gsapijaszko/mySensors_pir_relay/README.md

# mySensors_pir_relay
PIR/light relay with nRF24 radio, mySensors network

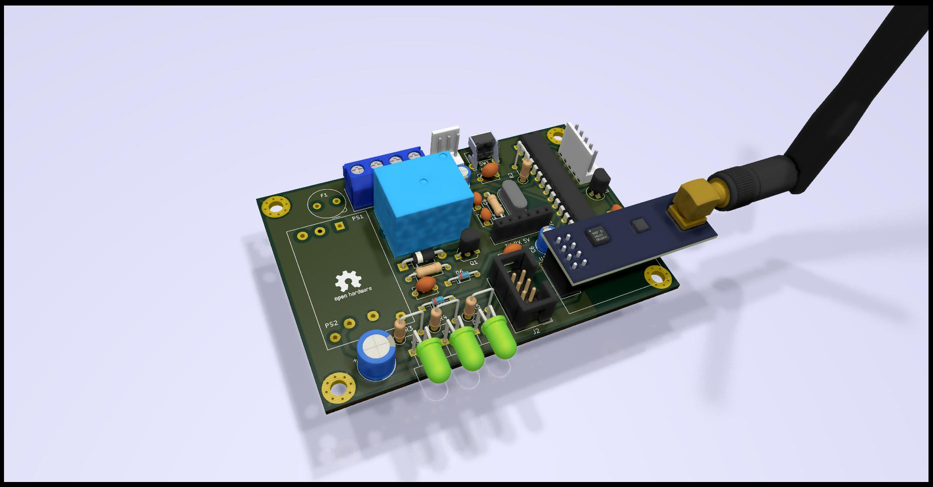
[picture p1: hardware/atmega328.jpg]
