gsapijaszko/mySensors_pir_relay/hardware/atmega328.ods

Source: | C:\projekty\atmega\atmega328\atmega328.sch
Date: | 2018-12-29 16:24:20
Tool: | Eeschema (6.0.0-rc1-dev-1429-g0c0dda54b)
Generator: | C:\Program Files (x86)\KiCad\bin\scripting\plugins/bom_csv_grouped_by_value_with_fp.py
Component Count: | 34
Ref | Qnty | Value | Cmp name | Footprint | Description | Vendor | Price | Currency | Value
C2, | 1 | 220uF | CP | Capacitor_THT:CP_Radial_D10.0mm_P5.00mm | Polarized capacitor |  | 0,1172 | PLN | 0,1172
C3, C1, | 2 | 22p | C | Capacitor_THT:C_Disc_D3.8mm_W2.6mm_P2.50mm | Unpolarized capacitor |  | 0,0517 | PLN | 0,1034
C7, C4, C6, | 3 | 100n | C | Capacitor_THT:C_Disc_D7.5mm_W5.0mm_P7.50mm | Unpolarized capacitor |  | 0,0517 | PLN | 0,1551
C8, C5, | 2 | 47uF | CP | Capacitor_THT:CP_Radial_D6.3mm_P2.50mm | Polarized capacitor |  | 0,1172 | PLN | 0,2344
D1, | 1 | 1N4145 | D | Diode_THT:D_DO-34_SOD68_P7.62mm_Horizontal | Diode |  |  |  | 0
D2, | 1 | 1N4007 | D | Diode_THT:D_DO-41_SOD81_P10.16mm_Horizontal | Diode |  |  |  | 0
D3, | 1 | 1N4148 | D | Diode_THT:D_DO-34_SOD68_P7.62mm_Horizontal | Diode |  |  |  | 0
D4, | 1 | red | LED | LED_THT:LED_D5.0mm_Horizontal_O3.81mm_Z9.0mm | Light emitting diode |  | 0,0363 | PLN | 0,0363
D5, | 1 | green | LED | LED_THT:LED_D5.0mm_Horizontal_O3.81mm_Z9.0mm | Light emitting diode |  | 0,0363 | PLN | 0,0363
D6, | 1 | yellow | LED | LED_THT:LED_D5.0mm_Horizontal_O3.81mm_Z9.0mm | Light emitting diode |  | 0,0363 | PLN | 0,0363
F1, | 1 | 500mA | Fuse | Fuse:Fuseholder_TR5_Littelfuse_No560_No460 | Fuse |  | 0,222 | PLN | 0,222
J1, | 1 | 220V | Conn_01x02_Male | kicad_libraries:KF301-2P-5.0 | Generic connector, single row, 01x02, script generated (kicad-library-utils/schlib/autogen/connector/) |  | 0,182 | PLN | 0,182
J2, | 1 | AVR-ISP-6 | AVR-ISP-6 | Connector_IDC:IDC-Header_2x03_P2.54mm_Vertical | Atmel 6-pin ISP connector |  |  |  | 0
J3, | 1 | PIR | Conn_01x03_Male | IFS_Connectors:KF2510-A-3P-M-TH-V | Generic connector, single row, 01x03, script generated (kicad-library-utils/schlib/autogen/connector/) |  | 2,908 | PLN | 2,908
J4, | 1 | BH1750 | Conn_01x05_Male | kicad_libraries:KF2510-A-5P-M-TH-V | Generic connector, single row, 01x05, script generated (kicad-library-utils/schlib/autogen/connector/) |  | 3,21 | PLN | 3,21
J5, | 1 | LAMP | Conn_01x02_Male | kicad_libraries:KF301-2P-5.0 | Generic connector, single row, 01x02, script generated (kicad-library-utils/schlib/autogen/connector/) |  | 0,182 | PLN | 0,182
K1, | 1 | SANYOU_SRD_Form_C | SANYOU_SRD_Form_C | Relay_THT:Relay_SPDT_SANYOU_SRD_Series_Form_C | Sanyo SRD relay, Single Pole Miniature Power Relay, |  | 1,2692 |  | 1,2692
PS1, | 1 | AC_DC_5V_3W | AC_DC_5V_3W-Converter_ACDC | Converter_ACDC:AC_DC_5V_3W |  |  | 2,87 |  | 2,87
Q1, | 1 | BC547 | BC547 | Package_TO_SOT_THT:TO-92_Inline | 0.1A Ic, 45V Vce, Small Signal NPN Transistor, TO-92 |  | 0,047666666666667 |  | 0,047666666666667
R1, | 1 | 1M | R | Resistor_THT:R_Axial_DIN0207_L6.3mm_D2.5mm_P10.16mm_Horizontal | Resistor |  | 0,01 |  | 0,01
R2, | 1 | 10k | R | Resistor_THT:R_Axial_DIN0207_L6.3mm_D2.5mm_P5.08mm_Vertical | Resistor |  | 0,01 |  | 0,01
R3, | 1 | 10k | R | Resistor_THT:R_Axial_DIN0207_L6.3mm_D2.5mm_P10.16mm_Horizontal | Resistor |  | 0,01 |  | 0,01
R4, R5, R6, | 3 | 470 | R | Resistor_THT:R_Axial_DIN0207_L6.3mm_D2.5mm_P5.08mm_Vertical | Resistor |  | 0,01 |  | 0,03
SW1, | 1 | SW_Push | SW_Push | Button_Switch_THT:SW_Tactile_SKHH_Angled | Push button switch, generic, two pins |  |  |  | 0
U1, | 1 | NRF24L01_Breakout | NRF24L01_Breakout | RF_Module:nRF24L01_Breakout | Ultra low power 2.4GHz RF Transceiver, Carrier PCB |  | 6,74 | PLN | 6,74
U2, | 1 | L78L33_TO92 | L78L33_TO92 | Package_TO_SOT_THT:TO-92_Inline | Positive 100mA 30V Linear Regulator, Fixed Output 3.3V, TO-92 |  | 0,398 | PLN | 0,398
U3, | 1 | ATmega328-PU | ATmega328-PU | Package_DIP:DIP-28_W7.62mm | 20MHz, 32kB Flash, 2kB SRAM, 1kB EEPROM, DIP-28 |  | 5 |  | 5
Y1, | 1 | Crystal | Crystal | Crystal:Crystal_HC49-U_Vertical | Two pin crystal |  | 0,2055 |  | 0,2055
 |  |  |  |  |  |  |  |  | 24,0133666666667
