gsapijaszko/mySensors_pir_relay/case/assembly.fcstd

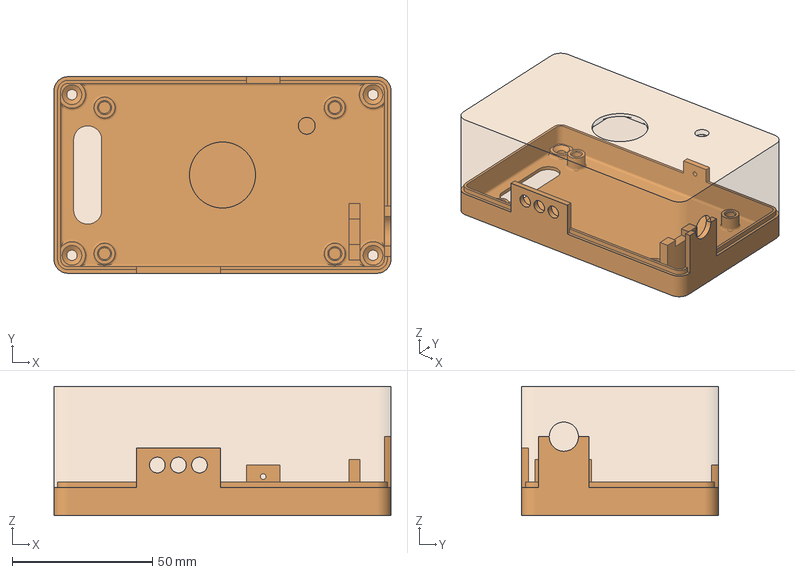
[picture p2: CAD file, 2020-01-12]
case/assembly.fcstd
120.0 x 70.0 x 46.0 mm
BottomPart
TopPart
