gsapijaszko/mySensors_pir_relay/hardware/atmega328.FCStd

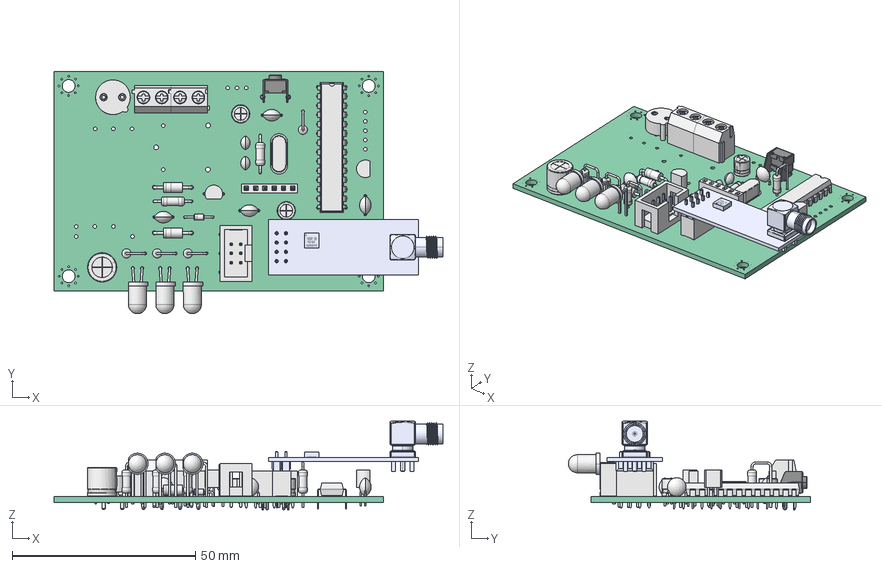
[picture p3: CAD file, 2020-01-12]
hardware/atmega328.FCStd
106.3 x 66.2 x 24.2 mm
Pcb_f059
C8_CP_Radial_D50mm_P200mm_5C228BFC x 2
D1_D_DO-41_SOD81_P10.16mm_Horizontal_5C228C1B x 2
C5_C_Disc_D51mm_W32mm_P500mm_5C2C32D8 x 4
J5_PinSocket_1x06_P254mm_Vertical_5C2BABEE
Y1_Crystal_HC49-4H_Vertical_5C2673D7
C1_CP_Radial_D80mm_P350mm_5C22DB62
U2_TO-92_Narrow_5C27EEBB
Q1_TO-92_Inline_Wide_5C2949E0
J6_TE_1776244-008_sp_5C2859B0 x 2
SW1_tactileswitch-right-angle-5mm_5C27D3F6[2]
J2_IDC_Header_2x03_P254mm_Vertical_5C228C8A
R5_R_Axial_DIN0207_L63mm_D25mm_P508mm_Vertical_5C26CE50 x 4
D5_LED_D5.0mm_Horizontal_O3.81mm_Z9.0mm_5C26CC1D x 3
F1_A_Littelfuse_No560_No460_5C258DC7
D6_D_DO-34_SOD68_P7.62mm_Horizontal_5C228C59
C4_C_Disc_D38mm_W26mm_P250mm_5C228A95 x 2
R1_R_Axial_DIN0207_L63mm_D25mm_P1016mm_Horizontal_5C228D38 x 2
U3_DIP-28_W7.62mm_5C27EC37
U1_NRF24L01_PCB_sp_5C228DAA[2]
U1_PinSocket_2x04_P254mm_Vertical_5C228DAA[3]
