gsapijaszko/mySensors_pir_relay/case/TopPart.stl

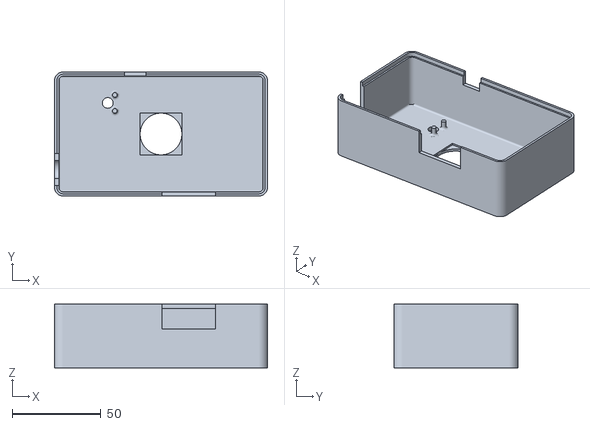
[picture p4: CAD file, 2020-01-12]
case/TopPart.stl
120.0 x 70.0 x 36.0
