gsapijaszko/mySensors_pir_relay/case/PIR_sensor.FCStd

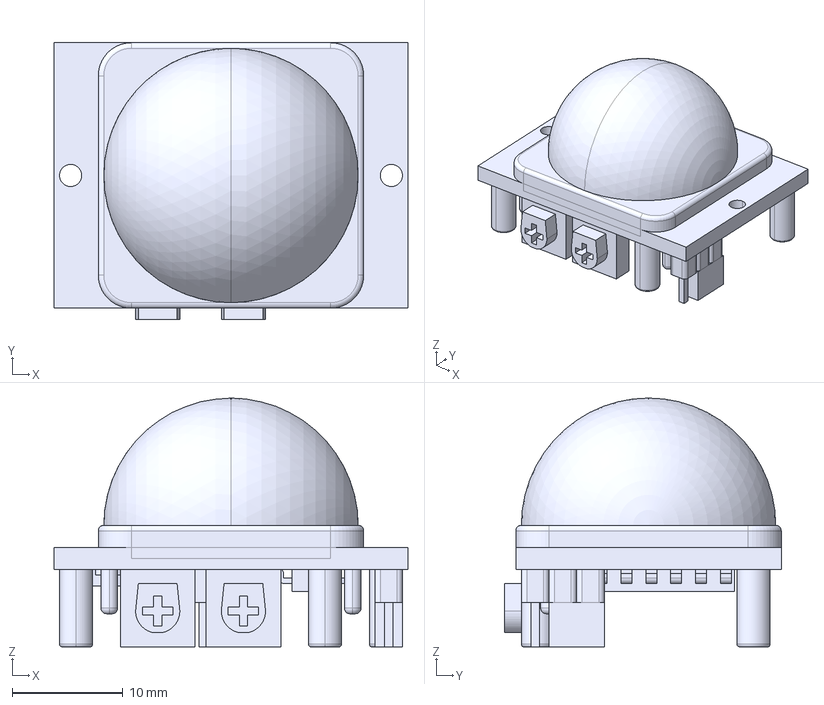
[picture p5: CAD file, 2019-01-06]
case/PIR_sensor.FCStd
32.0 x 25.0 x 22.5 mm
