gsapijaszko/mySensors_pir_relay/(list of files, cad)

Other CAD files:
hardware/atmega3281.FCStd
