gsapijaszko/mySensors_pir_relay/(list of files, drawings)

Other design files:
hardware/atmega328.dsn
