gsapijaszko/mySensors_pir_relay/hardware/atmega328.kicad_pcb

## KiCad design hardware/atmega328.kicad_pcb (2019-02-11)

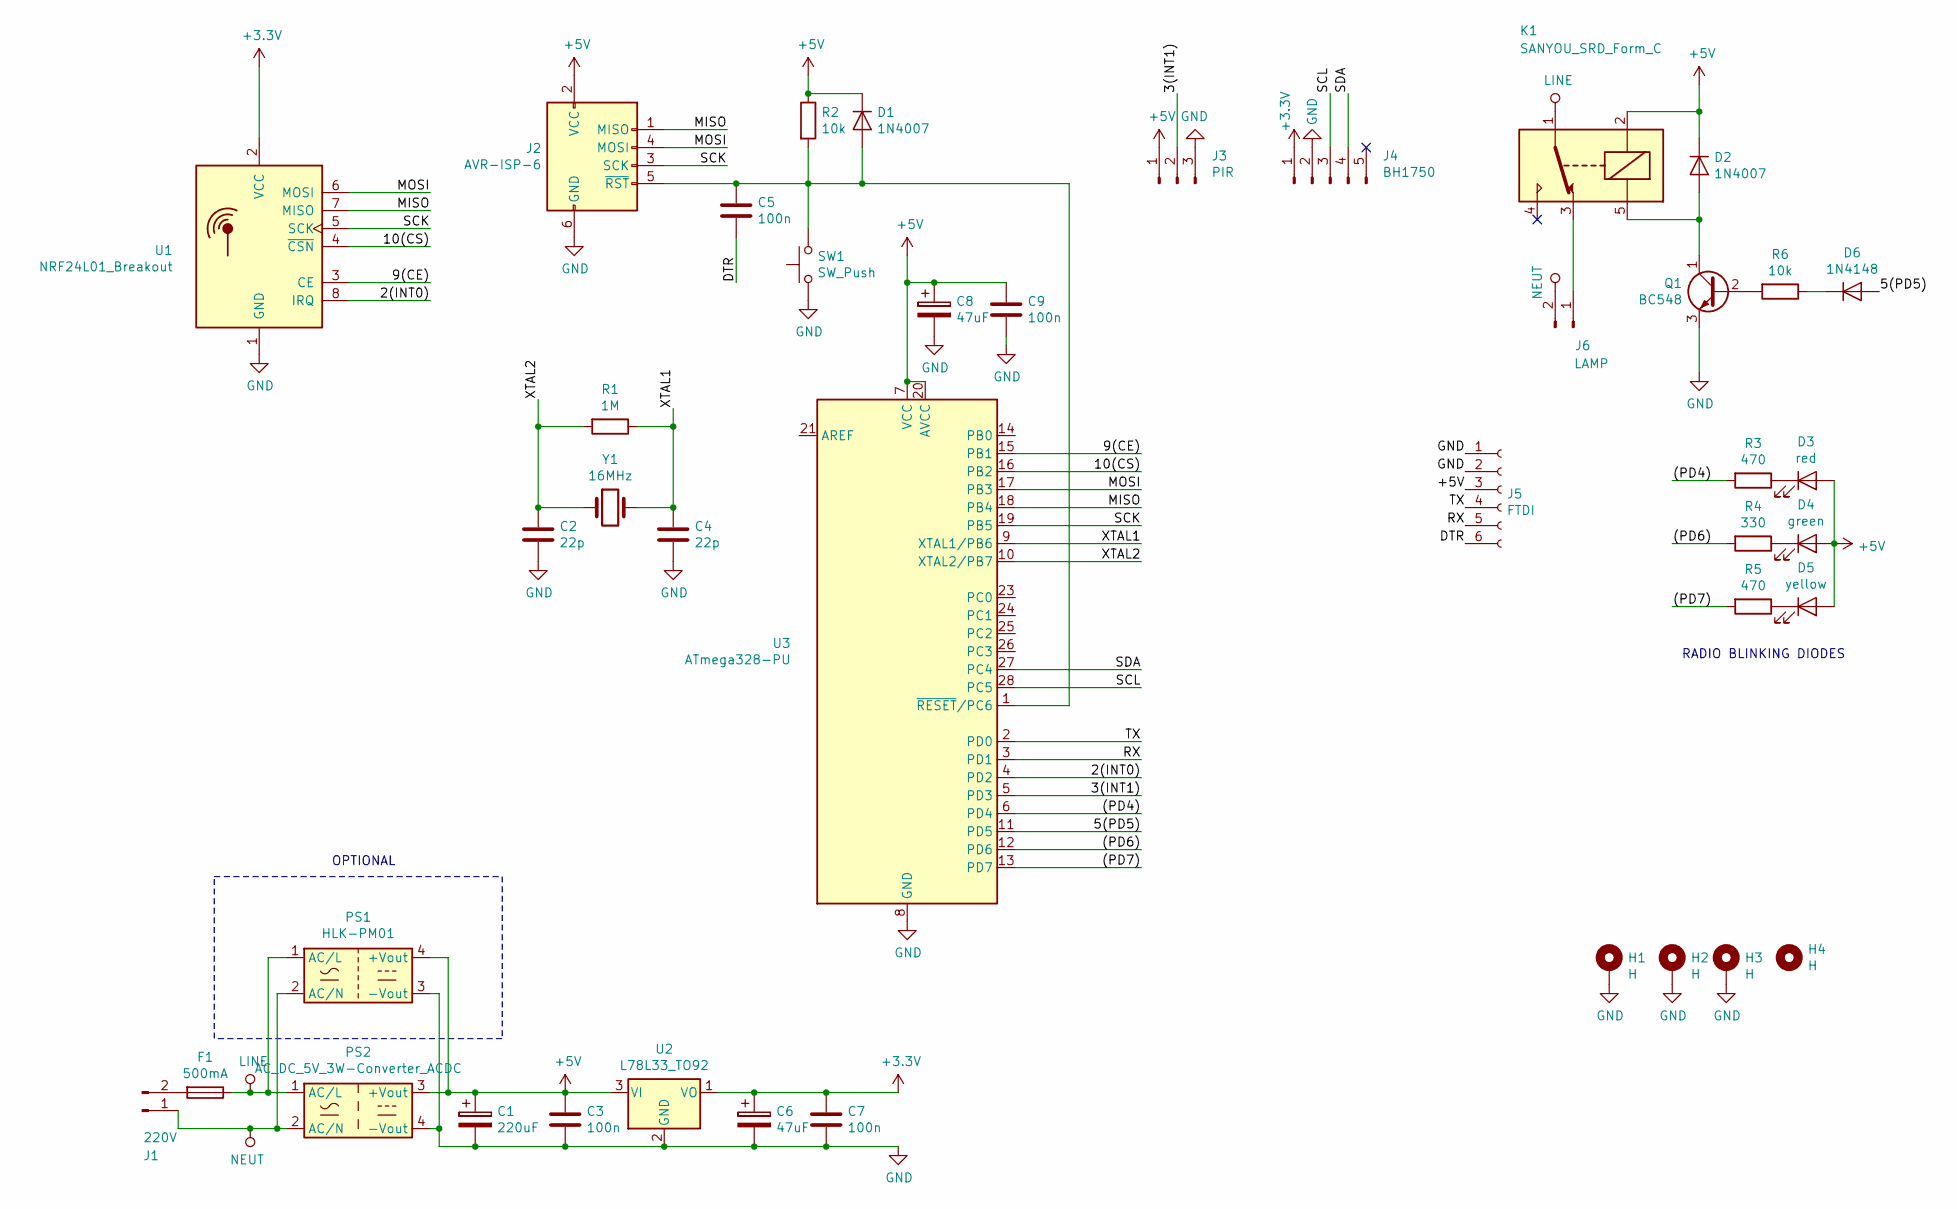
[picture p6: schematic atmega328.sch, mySensors PIR/BH1750 relay]

Parts:
C1: 220uF; CP_Radial_D8.0mm_P3.50mm
C2, C4: 22p; C_Disc_D3.8mm_W2.6mm_P2.50mm
C3, C5, C7, C9: 100n; C_Disc_D5.1mm_W3.2mm_P5.00mm
C6, C8: 47uF; CP_Radial_D5.0mm_P2.00mm
D1, D2: 1N4007; D_DO-41_SOD81_P10.16mm_Horizontal
D3: red; LED_D5.0mm_Horizontal_O3.81mm_Z9.0mm
D4: green; LED_D5.0mm_Horizontal_O3.81mm_Z9.0mm
D5: yellow; LED_D5.0mm_Horizontal_O3.81mm_Z9.0mm
D6: 1N4148; D_DO-34_SOD68_P7.62mm_Horizontal
F1: 500mA; Fuseholder_TR5_Littelfuse_No560_No460
H1, H2, H3, H4: H; MountingHole_3.5mm_Pad_Via
J1: 220V; KF301-2P-5.0
J2: AVR-ISP-6; IDC-Header_2x03_P2.54mm_Vertical
J3: PIR; KF2510-A-3P-M-TH-V
J4: BH1750; KF2510-A-5P-M-TH-V
J5: FTDI; PinSocket_1x06_P2.54mm_Vertical
J6: LAMP; KF301-2P-5.0
K1: SANYOU_SRD_Form_C; Relay_SPDT_SANYOU_SRD_Series_Form_C
PS1: HLK-PM01; Converter_ACDC_HiLink_HLK-PMxx
PS2: AC_DC_5V_3W-Converter_ACDC; AC_DC_5V_3W
Q1: BC548; TO-92_Inline_Wide
R1: 1M; R_Axial_DIN0207_L6.3mm_D2.5mm_P10.16mm_Horizontal
R2: 10k; R_Axial_DIN0207_L6.3mm_D2.5mm_P5.08mm_Vertical
R3, R5: 470; R_Axial_DIN0207_L6.3mm_D2.5mm_P5.08mm_Vertical
R4: 330; R_Axial_DIN0207_L6.3mm_D2.5mm_P5.08mm_Vertical
R6: 10k; R_Axial_DIN0207_L6.3mm_D2.5mm_P10.16mm_Horizontal
SW1: SW_Push; SW_Tactile_SKHH_Angled
U1: NRF24L01_Breakout; nRF24L01_Breakout
U2: L78L33_TO92; TO-92
U3: ATmega328-PU; DIP-28_W7.62mm
Y1: 16MHz; Crystal_HC49-4H_Vertical

Connections:
+3V3: C6.1, C7.1, J4.1, U1.2 (VCC), U2.1 (VO)
+5V: C1.1, C3.1, C8.1, C9.1, D1.1 (K), D2.1 (K), D3.2 (A), D4.2 (A), D5.2 (A), J2.2 (VCC), J3.1, J5.3, K1.2, PS1.4 (+Vout), PS2.3 (+Vout), R2.1, U2.3 (VI), U3.7 (VCC), U3.20 (AVCC)
/2(INT0): U1.8 (IRQ), U3.4 (PD2)
/3(INT1): J3.2, U3.5 (PD3)
/5(PD5): D6.2 (A), U3.11 (PD5)
/9(CE): U1.3 (CE), U3.15 (PB1)
/10(CS): U1.4 (~CSN), U3.16 (PB2)
/(PD4): R3.2, U3.6 (PD4)
/(PD6): R4.2, U3.12 (PD6)
/(PD7): R5.2, U3.13 (PD7)
/DTR: C5.2, J5.6
/MISO: J2.1 (MISO), U1.7 (MISO), U3.18 (PB4)
/MOSI: J2.4 (MOSI), U1.6 (MOSI), U3.17 (PB3)
/RX: J5.5, U3.3 (PD1)
/SCK: J2.3 (SCK), U1.5 (SCK), U3.19 (PB5)
/SCL: J4.3, U3.28 (PC5)
/SDA: J4.4, U3.27 (PC4)
/TX: J5.4, U3.2 (PD0)
/XTAL1: C4.1, R1.1, U3.9 (XTAL1/PB6), Y1.2
/XTAL2: C2.1, R1.2, U3.10 (XTAL2/PB7), Y1.1
GND: C1.2, C2.2, C3.2, C4.2, C6.2, C7.2, C8.2, C9.2, H1.1, H2.1, H3.1, J2.6 (GND), J3.3, J4.2, J5.1, J5.2, PS1.3 (-Vout), PS2.4 (-Vout), Q1.3 (E), SW1.1, U1.1 (GND), U2.2 (GND), U3.8 (GND), U3.22 (GND)
LINE: F1.1, K1.1, PS1.1 (AC/L), PS2.1 (AC/L)
NEUT: J1.1, J6.2, PS1.2 (AC/N), PS2.2 (AC/N)
unnamed: C5.1, D1.2 (A), J2.5 (~RST), R2.2, SW1.2, U3.1 (~RESET~/PC6)
unnamed: D2.2 (A), K1.5, Q1.1 (C)
unnamed: D3.1 (K), R3.1
unnamed: D4.1 (K), R4.1
unnamed: D5.1 (K), R5.1
unnamed: D6.1 (K), R6.1
unnamed: F1.2, J1.2
unnamed: J6.1, K1.3
unnamed: Q1.2 (B), R6.2

Notes on the sheet:
RADIO BLINKING DIODES
OPTIONAL

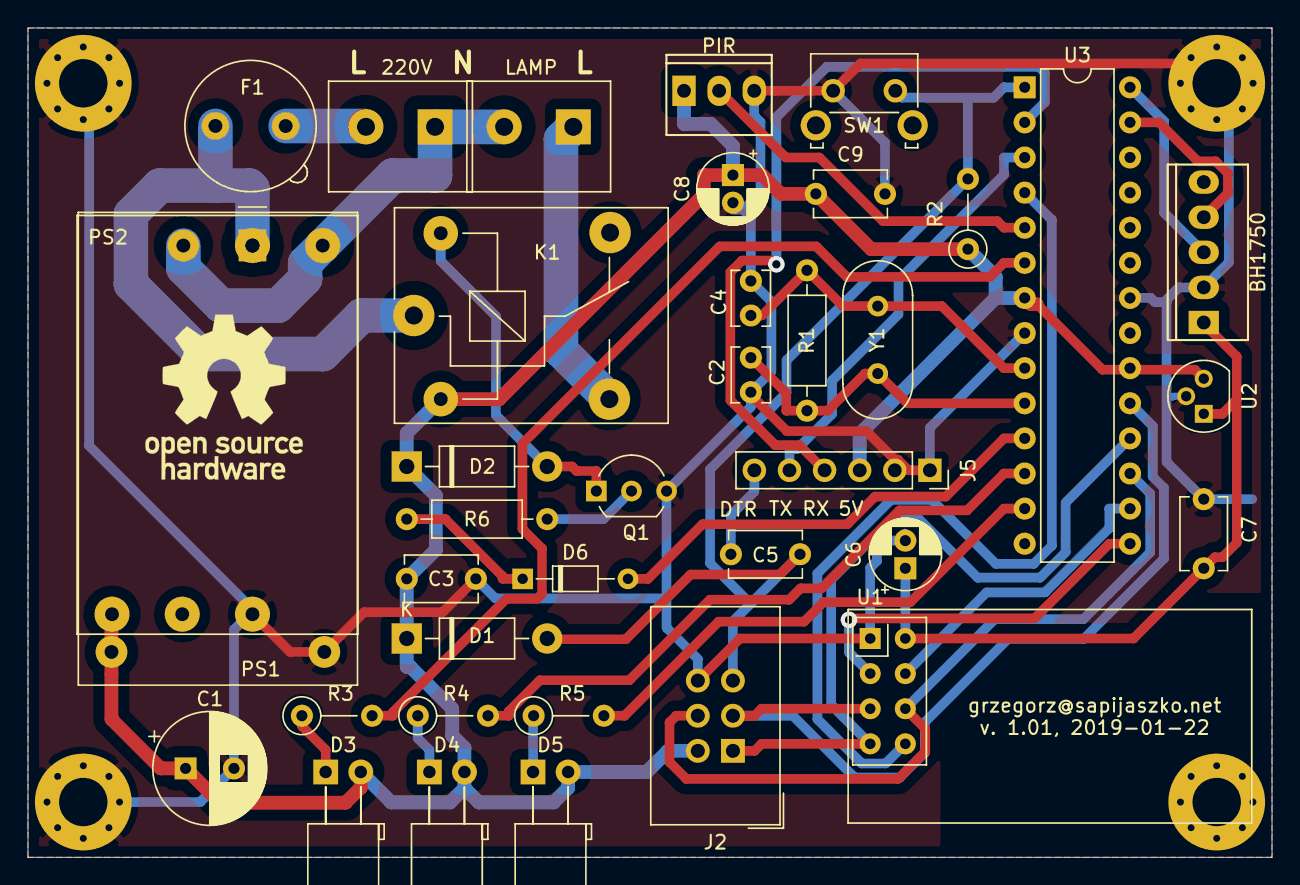
[picture p7: board atmega328.kicad_pcb from above]

Board: 2 copper layers, 90.0 x 60.0 mm, 41 parts (0 on the bottom side), 32 nets.
