gsapijaszko/mySensors_pir_relay/(commit log)

2018-12-30 initial commit
    initial commit, based on old solution: arduino pro mini + modules
    [case.scad]
2018-12-30 hardware added
    [_saved_file5C26D6AD.sch, atmega328.csv, atmega328.dsn, atmega328.kicad_pcb, atmega328.ods, atmega328.sch, case.FCStd, case_old_for_arduino_and_modules.scad]
2018-12-30 case in freecad
    [case.FCStd]
2018-12-30 minor updates
    [atmega328.dsn, atmega328.kicad_pcb]
2018-12-31 case redrawn
    [atmega328.fcstd, atmega328.kicad_pcb, case.FCStd, case.fcstd]
2018-12-31 moved radio up, support added
    [atmega328.FCStd, atmega328.kicad_pcb, case.fcstd]
2019-01-01 another try for case
    [case.fcstd]
2019-01-01 Update case.fcstd, case.fcstd1, and atmega328-rescue.lib
    [case.fcstd]
2019-01-01 Revert "Update case.fcstd, case.fcstd1, and atmega328-rescue.lib"
    This reverts commit 71372981b5001050260e6a5e78be0348375636c0.
2019-01-01 FTDI added, minor adjustments
    [_saved_file5C26D6AD.sch, atmega328.FCStd, atmega328.dsn, atmega328.fcstd, atmega328.kicad_pcb, atmega328.sch, case.fcstd]
2019-01-02 Update case.fcstd, case.fcstd1, and 3 more files...
    [case.fcstd, upper_part.FCStd]
2019-01-03 Update case.fcstd, case.fcstd1, and 14 more files...
    [atmega328-B.Cu.gbr, atmega328-B.Mask.gbr, atmega328-B.Paste.gbr, atmega328-B.SilkS.gbr, atmega328-Edge.Cuts.gbr, atmega328-F.Cu.gbr, atmega328-F.Mask.gbr, atmega328-F.Paste.gbr]
2019-01-05 Update case.fcstd, case.fcstd1, and 31 more files...
    [atmega328-B.Cu.gbr, atmega328-B.Mask.gbr, atmega328-B.Paste.gbr, atmega328-B.SilkS.gbr, atmega328-Edge.Cuts.gbr, atmega328-F.Cu.gbr, atmega328-F.Mask.gbr, atmega328-F.Paste.gbr]
2019-01-05 Update assembly.fcstd, assembly.fcstd1, and 6 more files...
    [assembly.fcstd, case.fcstd, lower_part.fcstd, upper_part.FCStd]
2019-01-05 Update assembly.fcstd, assembly.fcstd1, and 9 more files...
    [assembly.fcstd, case.fcstd, lower_part.fcstd, upper_part.FCStd]
2019-01-06 Update .gitignore, PIR_sensor.FCStd, and 5 more files...
    [PIR_sensor.FCStd, atmega328.kicad_pcb]
2019-01-06 Update assembly.fcstd, assembly.fcstd1, and 4 more files...
    [assembly.fcstd, case.fcstd, upper_part.FCStd]
2019-01-06 Update clip.FCStd, clip.FCStd1, and 3 more files...
    [clip.FCStd, test.FCStd, upper_part.FCStd]
2019-01-16 Update atmega328-rescue.dcm, atmega328.kicad_pcb, and 15 more files...
    [atmega328-B.Cu.gbr, atmega328-B.Mask.gbr, atmega328-B.Paste.gbr, atmega328-B.SilkS.gbr, atmega328-Edge.Cuts.gbr, atmega328-F.Cu.gbr, atmega328-F.Mask.gbr, atmega328-F.Paste.gbr]
2019-01-18 Update atmega328.xml, bom.ini, and ibom.html
2019-01-18 Update atmega328.bak, atmega328.kicad_pcb, and 5 more files...
    [atmega328.kicad_pcb, atmega328.sch]
2019-01-22 Update _autosave-atmega328.kicad_pcb, atmega328.kicad_pcb, and 13 more files...
    [atmega328-B_Cu.gbr, atmega328-B_Mask.gbr, atmega328-B_Paste.gbr, atmega328-B_SilkS.gbr, atmega328-Edge_Cuts.gbr, atmega328-F_Cu.gbr, atmega328-F_Mask.gbr, atmega328-F_Paste.gbr]
2019-01-22 Update _autosave-atmega328.kicad_pcb, atmega328.kicad_pcb, and atmega328.kicad_pcb-bak
    [atmega328.kicad_pcb]
2019-02-11 revision of diode's resistors
    [atmega328.kicad_pcb, atmega328.sch]
2019-02-11 Update atmega328.kicad_pcb, ibom.html, and fp-info-cache
    [atmega328.kicad_pcb]
2019-02-23 Update BottomPart.stl, assembly.fcstd, and 2 more files...
    [assembly.fcstd]
2019-03-23 Update lower_part.fcstd and lower_part.fcstd1
    [lower_part.fcstd]
2019-03-30 Update lower_part.fcstd, lower_part.fcstd1, and 2 more files...
    [lower_part.fcstd, upper_part.FCStd]
2019-12-30 Update case_top.FCStd, case_top.FCStd1, and 3 more files...
    [case_top.FCStd, upper_part.FCStd]
2020-01-12 case finished
    [TopPart.stl, assembly.fcstd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]
